HeyPCB/phone-robot/fab/phone_robot_bom.csv

Reference | Value | Footprint | MPN | LCSC | Qty
C1,C4 | 10uF | Capacitor_SMD:C_0805_2012Metric | CL21A106KAYNNNE | C15850 | 2
C2 | 10nF | Capacitor_SMD:C_0603_1608Metric | 0603B103K500NT | C57112 | 1
C3,C5 | 100nF | Capacitor_SMD:C_0603_1608Metric | CC0603KRX7R9BB104 | C14663 | 2
C6,C7 | 100nF | Capacitor_SMD:C_0402_1005Metric | CL05B104KO5NNNC | C1525 | 2
D1,D2 | WS2812C-2020-V1 | LED_SMD:LED_WS2812B-2020_PLCC4_2.0x2.0mm | WS2812C-2020-V1 | C2976072 | 2
J1 | USB-C | Connector_USB:USB_C_Receptacle_HRO_TYPE-C-31-M-12 | TYPE-C-31-M-12 | C165948 | 1
J2 | USB-C out | Connector_USB:USB_C_Receptacle_HRO_TYPE-C-31-M-12 | TYPE-C-31-M-12 | C165948 | 1
Q1 | AO3401A | Package_TO_SOT_SMD:SOT-23 | AO3401A | C15127 | 1
Q2 | AO3400A | Package_TO_SOT_SMD:SOT-23 | AO3400A | C20917 | 1
R1,R2 | 5.1k | Resistor_SMD:R_0402_1005Metric | 0402WGF5101TCE | C25905 | 2
R3,R5 | 100k | Resistor_SMD:R_0603_1608Metric | 0603WAF1003T5E | C25803 | 2
R4,R7,R8 | 22k | Resistor_SMD:R_0603_1608Metric | 0603WAF2202T5E | C31850 | 3
R6 | 20m | Resistor_SMD:R_1206_3216Metric | FRM121WFR020TM | C7420010 | 1
R9,R10 | 56k | Resistor_SMD:R_0603_1608Metric | 0603WAF5602T5E | C23206 | 2
R11 | 10k | Resistor_SMD:R_0402_1005Metric | 0402WGF1002TCE | C25744 | 1
R12 | 1k | Resistor_SMD:R_0603_1608Metric | 0603WAF1001T5E | C21190 | 1
U1 | INA180A2 | Package_TO_SOT_SMD:SOT-23-5 | INA180A2IDBVR | C192764 | 1
U2 | CH32V003F4P6 | Package_SO:TSSOP-20_4.4x6.5mm_P0.65mm | CH32V003F4P6 | C5187096 | 1
