HeyPCB/phone-robot/fab/phone_robot.step

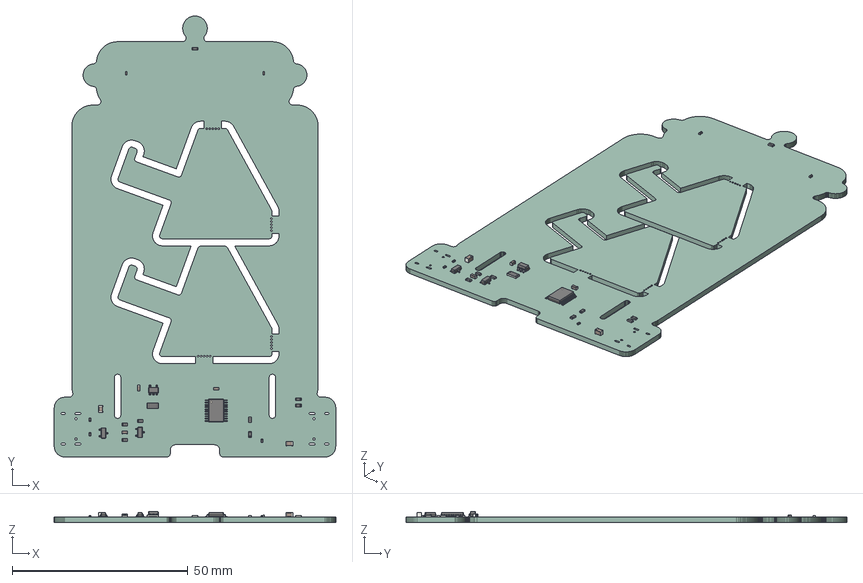
[picture p4: CAD file, 2026-10-05]
fab/phone_robot.step
80.0 x 125.3 x 3.15 mm
C_0603_1608Metric x 3
R_0603_1608Metric x 8
R_0402_1005Metric x 3
SOT-23-5
C_0805_2012Metric x 2
C_0402_1005Metric x 2
SOT-23 x 2
TSSOP-20_4.4x6.5mm_P0.65mm
R_1206_3216Metric
phone_robot_PCB
