HeyPCB/phone-robot/fab/phone_robot_schematic.pdf

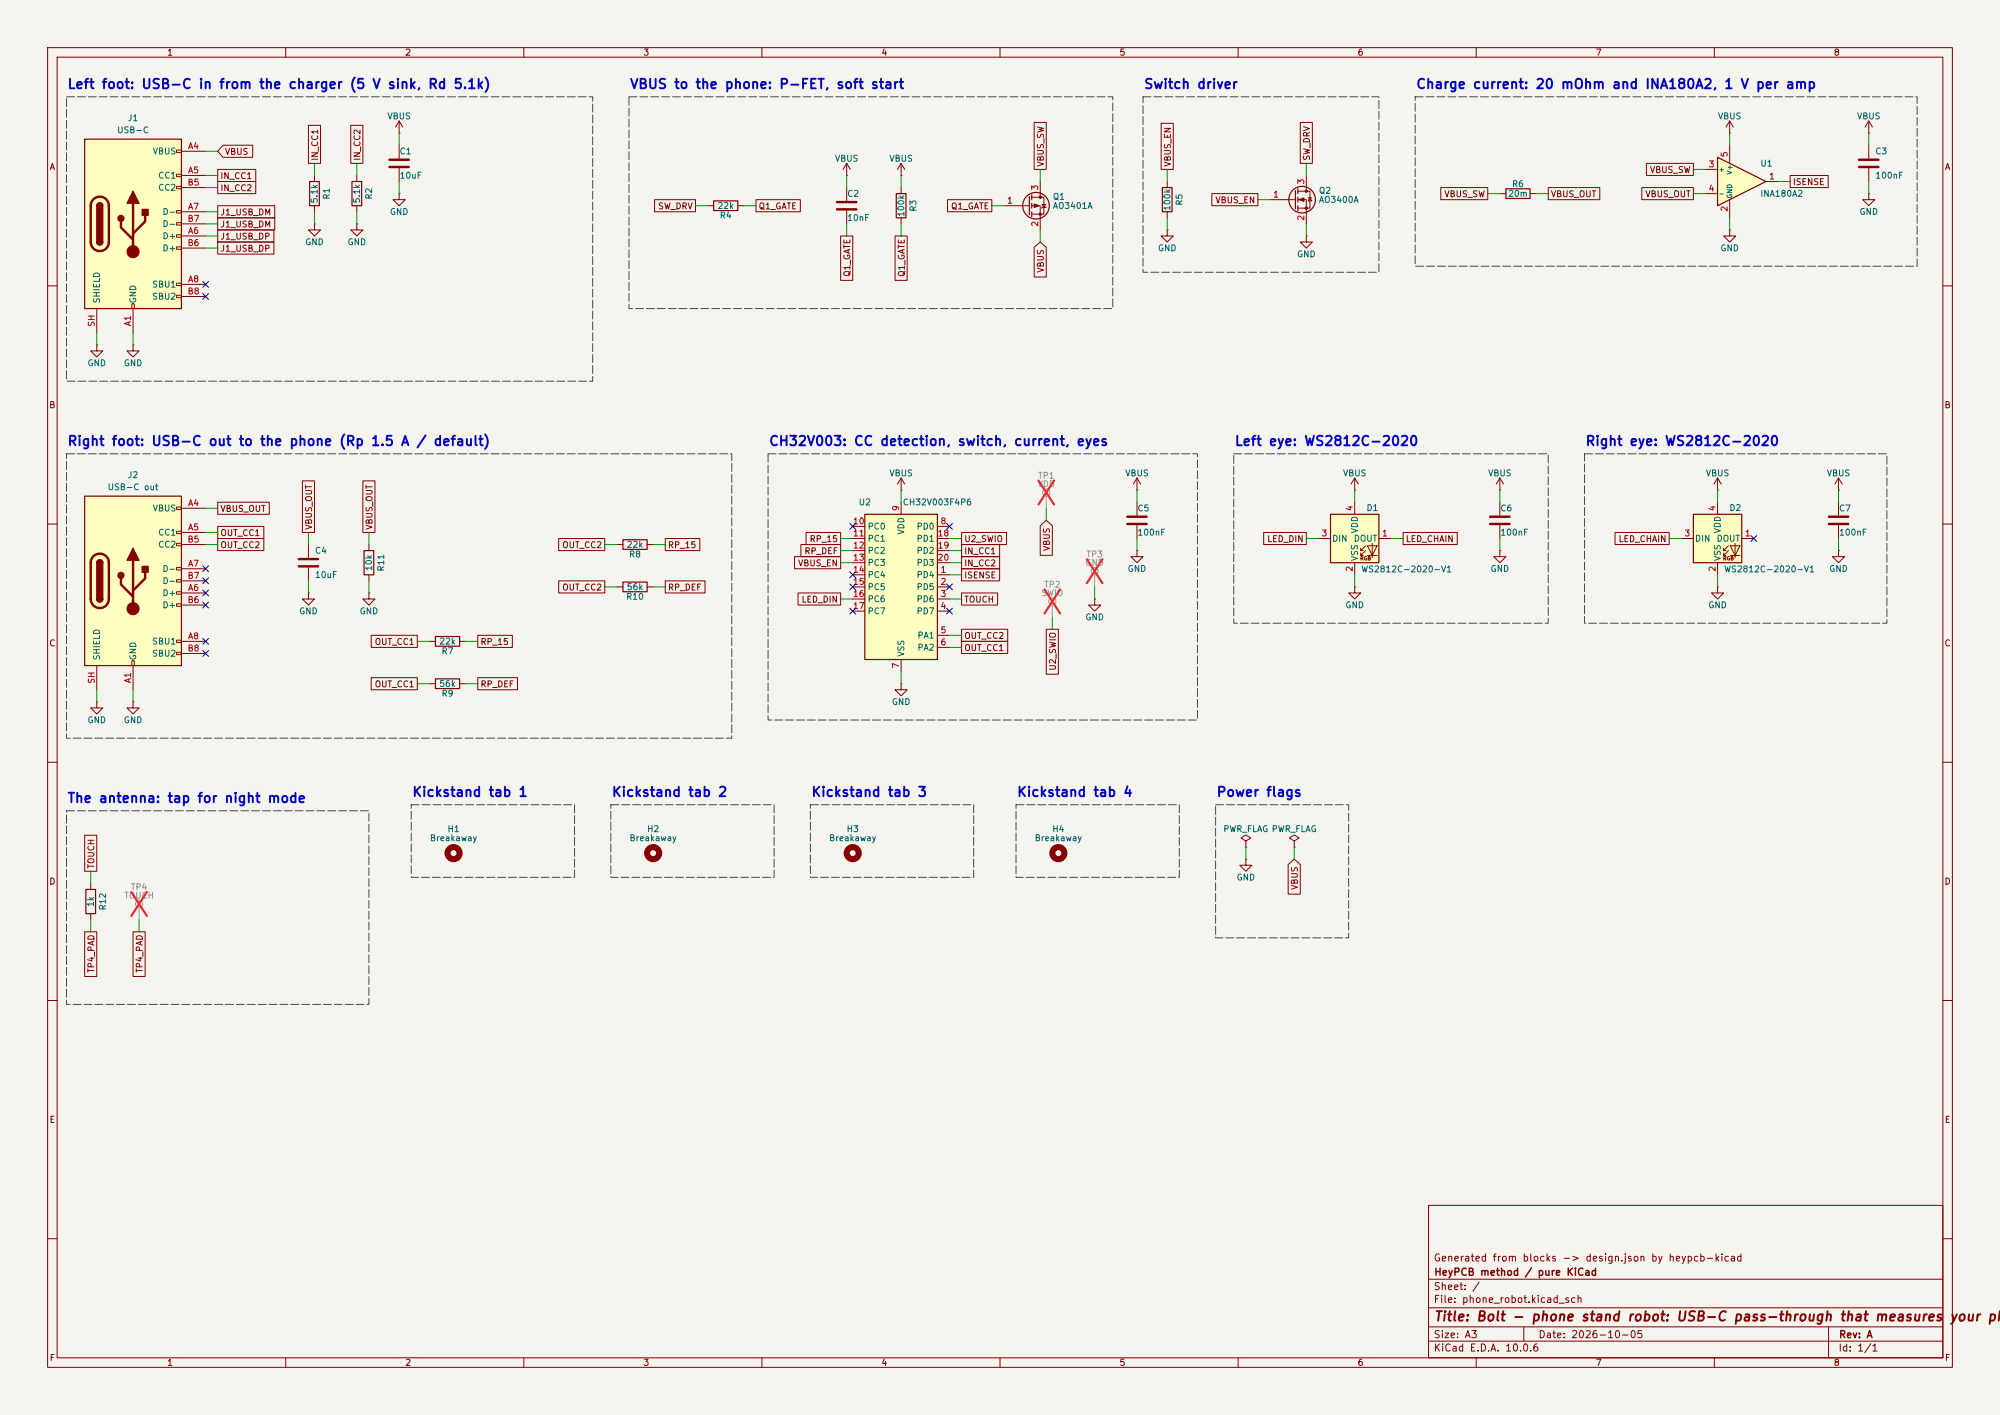
[picture p5: page 1]

Left foot: USB-C in from the charger (5 V sink, Rd 5.1k)

TOUCH Kickstand tab 1 The antenna: tap for night mode

Generated from blocks -> design.json by heypcb-kicad
HeyPCB method / pure KiCad
Sheet: /
File: phone_robot.kicad_sch
Title: Bolt - phone stand robot: USB-C pass-through that measures your phone charging, RGB eyes

Size: A3 | Rev: A | F Date: 2026-10-05
KiCad E.D.A. 10.0.6 | Id: 1/1
