HeyPCB/phone-robot/kicad/phone_robot.kicad_pcb

## KiCad design kicad/phone_robot.kicad_pcb (2026-10-05)

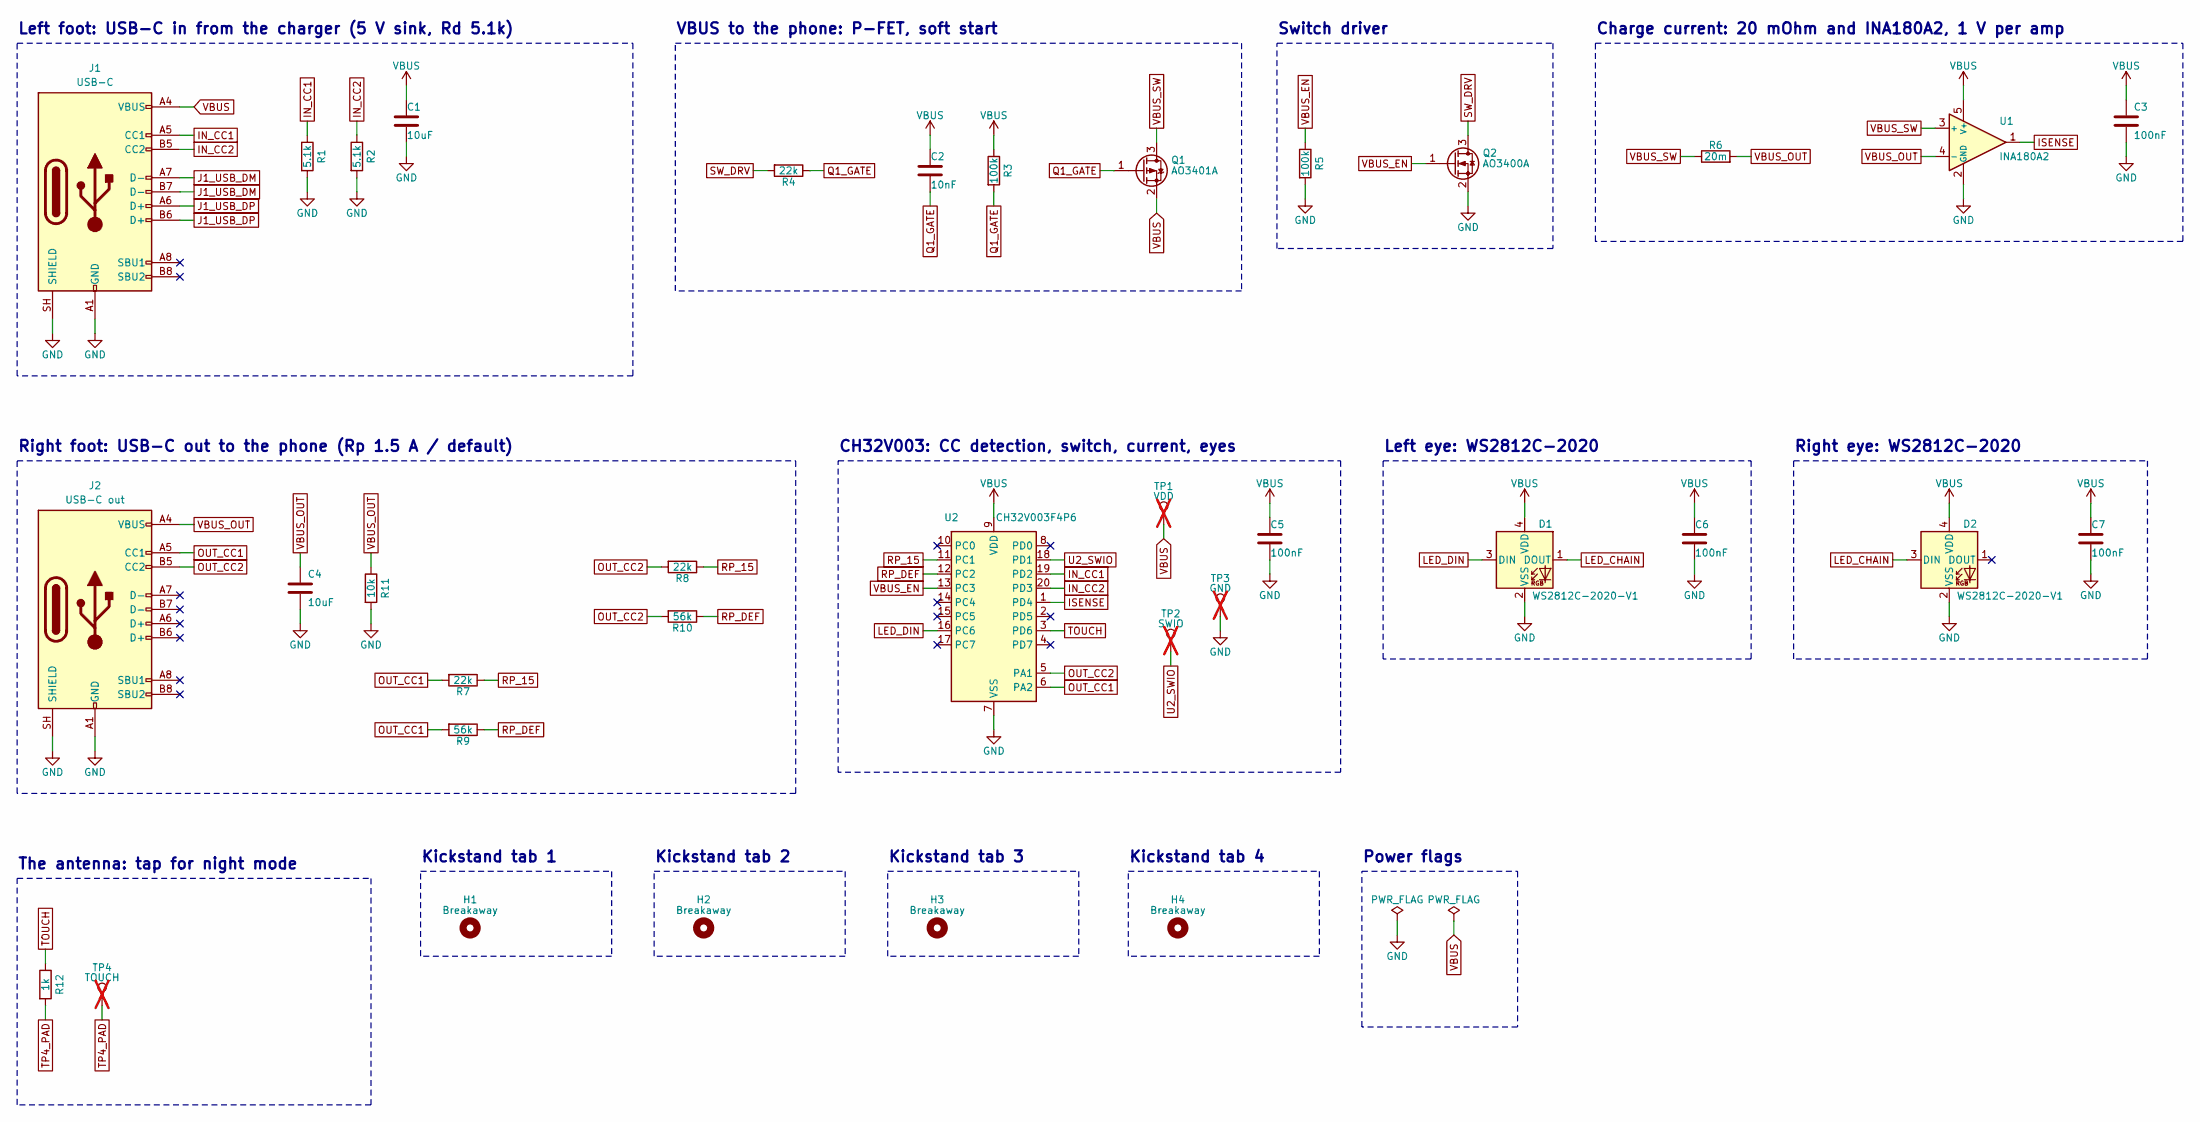
[picture p6: schematic phone_robot.kicad_sch, Bolt - phone stand robot: USB-C pass-through that measures …]

Parts:
C1, C4: 10uF; C_0805_2012Metric; MPN CL21A106KAYNNNE; LCSC C15850
C2: 10nF; C_0603_1608Metric; MPN 0603B103K500NT; LCSC C57112
C3, C5: 100nF; C_0603_1608Metric; MPN CC0603KRX7R9BB104; LCSC C14663
C6, C7: 100nF; C_0402_1005Metric; MPN CL05B104KO5NNNC; LCSC C1525
D1, D2: WS2812C-2020-V1; LED_WS2812B-2020_PLCC4_2.0x2.0mm; MPN WS2812C-2020-V1; LCSC C2976072
H1, H2, H3, H4: Breakaway; BreakLine_5h_D0.5mm_P0.85mm
J1: USB-C; USB_C_Receptacle_HRO_TYPE-C-31-M-12; MPN TYPE-C-31-M-12; LCSC C165948
J2: USB-C out; USB_C_Receptacle_HRO_TYPE-C-31-M-12; MPN TYPE-C-31-M-12; LCSC C165948
Q1: AO3401A; SOT-23; MPN AO3401A; LCSC C15127
Q2: AO3400A; SOT-23; MPN AO3400A; LCSC C20917
R1, R2: 5.1k; R_0402_1005Metric; MPN 0402WGF5101TCE; LCSC C25905
R3, R5: 100k; R_0603_1608Metric; MPN 0603WAF1003T5E; LCSC C25803
R4, R7, R8: 22k; R_0603_1608Metric; MPN 0603WAF2202T5E; LCSC C31850
R6: 20m; R_1206_3216Metric; MPN FRM121WFR020TM; LCSC C7420010
R9, R10: 56k; R_0603_1608Metric; MPN 0603WAF5602T5E; LCSC C23206
R11: 10k; R_0402_1005Metric; MPN 0402WGF1002TCE; LCSC C25744
R12: 1k; R_0603_1608Metric; MPN 0603WAF1001T5E; LCSC C21190
TP1: VDD; TestPoint_Pad_1.0x1.0mm; not fitted
TP2: SWIO; TestPoint_Pad_1.0x1.0mm; not fitted
TP3: GND; TestPoint_Pad_1.0x1.0mm; not fitted
TP4: TOUCH; TestPoint_Pad_D4.0mm; not fitted
U1: INA180A2; SOT-23-5; MPN INA180A2IDBVR; LCSC C192764
U2: CH32V003F4P6; TSSOP-20_4.4x6.5mm_P0.65mm; MPN CH32V003F4P6; LCSC C5187096

Connections:
GND: C1.2, C3.2, C4.2, C5.2, C6.2, C7.2, D1.2 (VSS), D2.2 (VSS), J1.A1 (GND), J1.A12 (GND), J1.B1 (GND), J1.B12 (GND), J1.SH (SHIELD), J2.A1 (GND), J2.A12 (GND), J2.B1 (GND), J2.B12 (GND), J2.SH (SHIELD), Q2.2 (S), R1.2, R2.2, R5.2, R11.2, TP3.1, U1.2 (GND), U2.7 (VSS)
IN_CC1: J1.A5 (CC1), R1.1, U2.19 (PD2)
IN_CC2: J1.B5 (CC2), R2.1, U2.20 (PD3)
ISENSE: U1.1, U2.1 (PD4)
J1_USB_DM: J1.A7 (D-), J1.B7 (D-)
J1_USB_DP: J1.A6 (D+), J1.B6 (D+)
LED_CHAIN: D1.1 (DOUT), D2.3 (DIN)
LED_DIN: D1.3 (DIN), U2.16 (PC6)
OUT_CC1: J2.A5 (CC1), R7.2, R9.2, U2.6 (PA2)
OUT_CC2: J2.B5 (CC2), R8.2, R10.2, U2.5 (PA1)
Q1_GATE: C2.2, Q1.1 (G), R3.2, R4.1
RP_15: R7.1, R8.1, U2.11 (PC1)
RP_DEF: R9.1, R10.1, U2.12 (PC2)
SW_DRV: Q2.3 (D), R4.2
TOUCH: R12.1, U2.3 (PD6)
TP4_PAD: R12.2, TP4.1
U2_SWIO: TP2.1, U2.18 (PD1)
VBUS: C1.1, C2.1, C3.1, C5.1, C6.1, C7.1, D1.4 (VDD), D2.4 (VDD), J1.A4 (VBUS), J1.A9 (VBUS), J1.B4 (VBUS), J1.B9 (VBUS), Q1.2 (S), R3.1, TP1.1, U1.5 (V+), U2.9 (VDD)
VBUS_EN: Q2.1 (G), R5.1, U2.13 (PC3)
VBUS_OUT: C4.1, J2.A4 (VBUS), J2.A9 (VBUS), J2.B4 (VBUS), J2.B9 (VBUS), R6.2, R11.1, U1.4 (-)
VBUS_SW: Q1.3 (D), R6.1, U1.3 (+)

Notes on the sheet:
Left foot: USB-C in from the charger (5 V sink, Rd 5.1k)
VBUS to the phone: P-FET, soft start
Switch driver
Charge current: 20 mOhm and INA180A2, 1 V per amp
Right foot: USB-C out to the phone (Rp 1.5 A / default)
CH32V003: CC detection, switch, current, eyes
Left eye: WS2812C-2020
Right eye: WS2812C-2020
The antenna: tap for night mode
Kickstand tab 1
Kickstand tab 2
Kickstand tab 3
Kickstand tab 4
Power flags

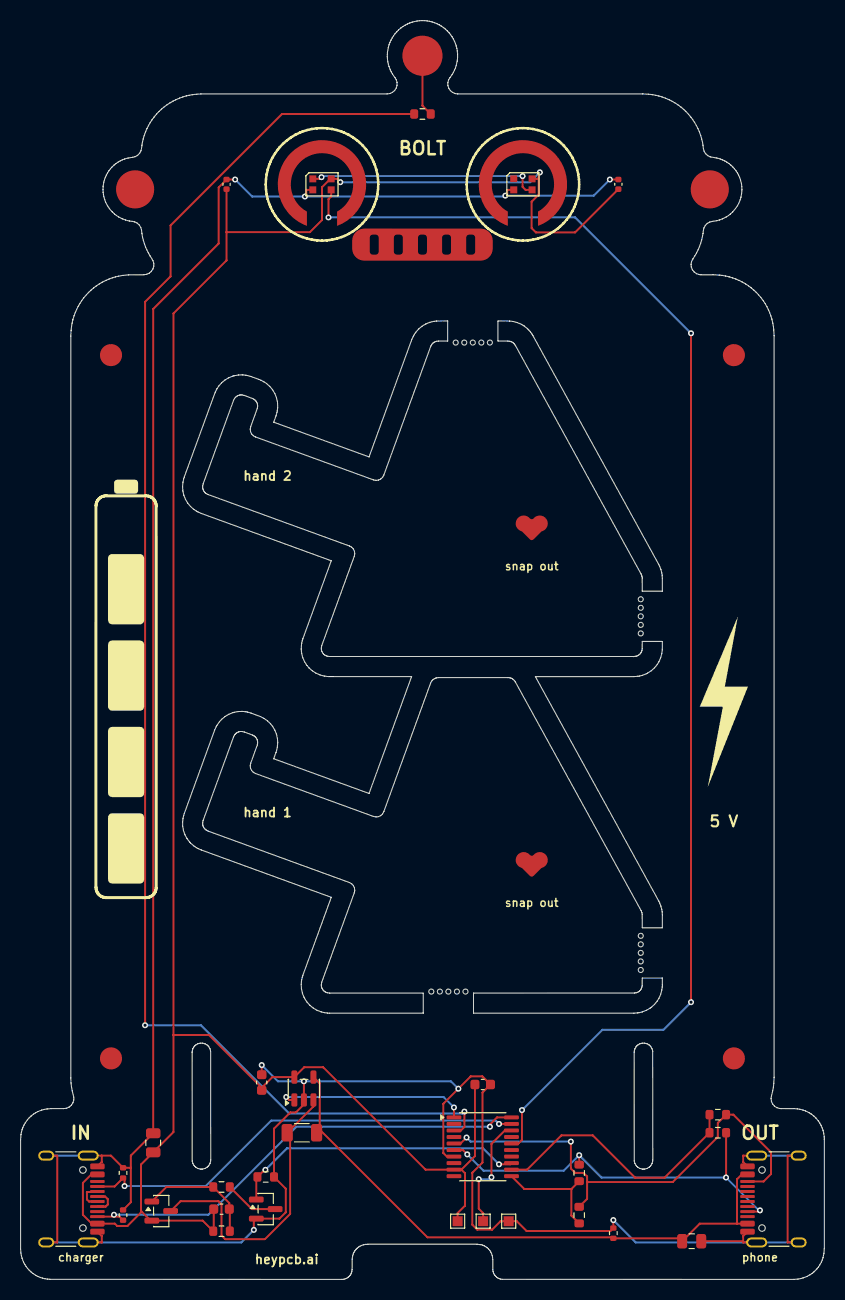
[picture p7: board phone_robot.kicad_pcb from above]

Board: 2 copper layers, 80.0 x 125.3 mm, 35 parts (0 on the bottom side), 21 nets.
